esp32vn/esp32-iot-uno/README.md

# esp32-iot-uno 

## Hardware features

- ESP32 WiFi, Bluetooth LE SoC - 240Mhz - Module ESP-WROOM-32
- Automatic select 3 power sources (DC6-28V, USB and Battery)
- Auto download Flash mode
- Integrated SDCARD slot (support 1-bit mode)
- Open hardware design with KiCad, CC-BY-SA license.
- I2C OLED display header 
- Lithium-Ion Battery Charger
- 1 Reset button, 1 programable button
- 1 Power LED, 1 programable LED, 1 Charger LED 
- Compatible with Shields for ESP32 in the future (Gateway - GSM/GPRS/GPS and Lora Shield, Connectivity - CAN, RS485, RS232 Shield, Audio Shield, ...)

### Images

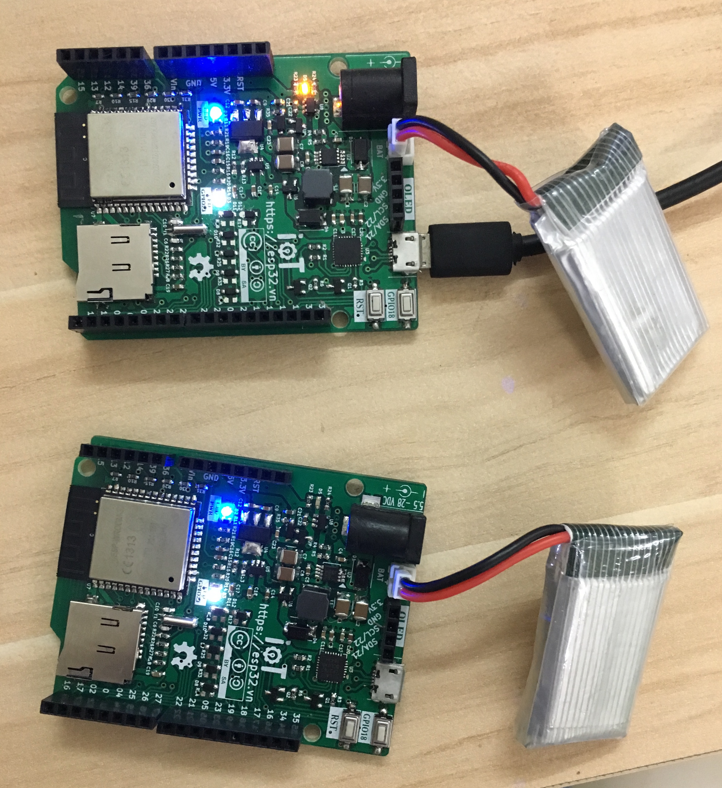
[picture p1: assets/esp32_uno_0776.jpg]
ESP32 IoT UNO Images1


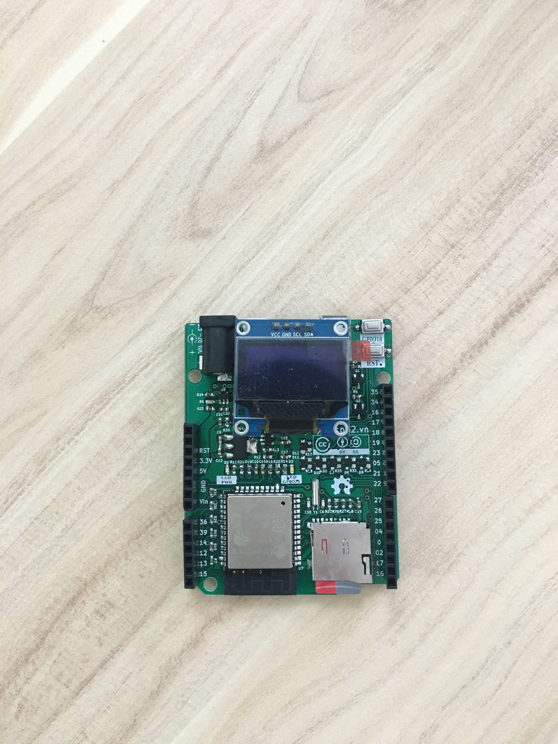
[picture p2: assets/esp32_uno_0826.jpg]
ESP32 IoT UNO Images2


### Pinout:

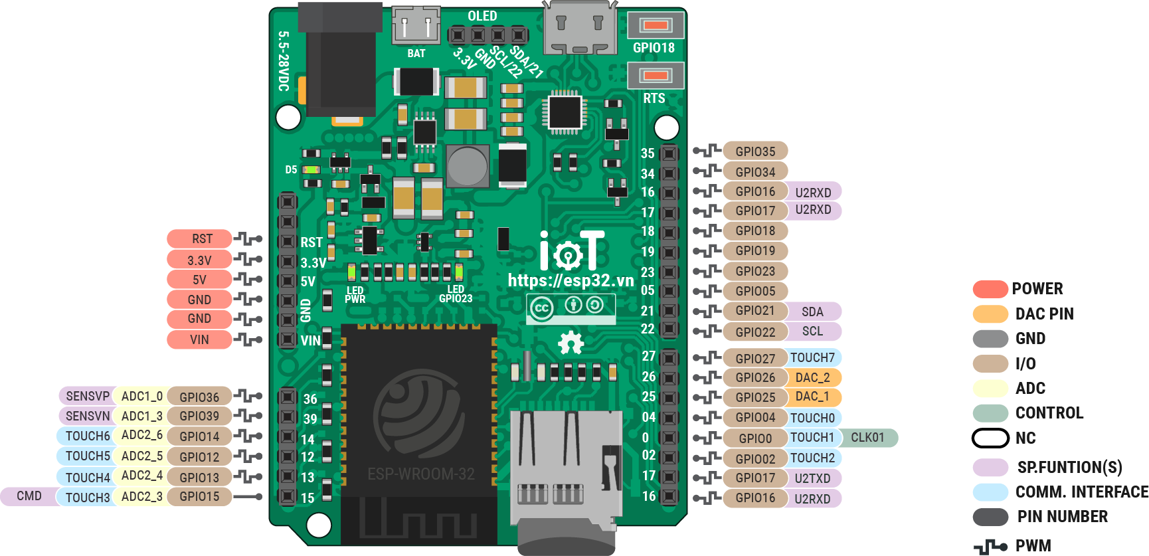
[picture p3: assets/Esp32-pinout.png]
ESP32 IoT Pinout


### Schematic

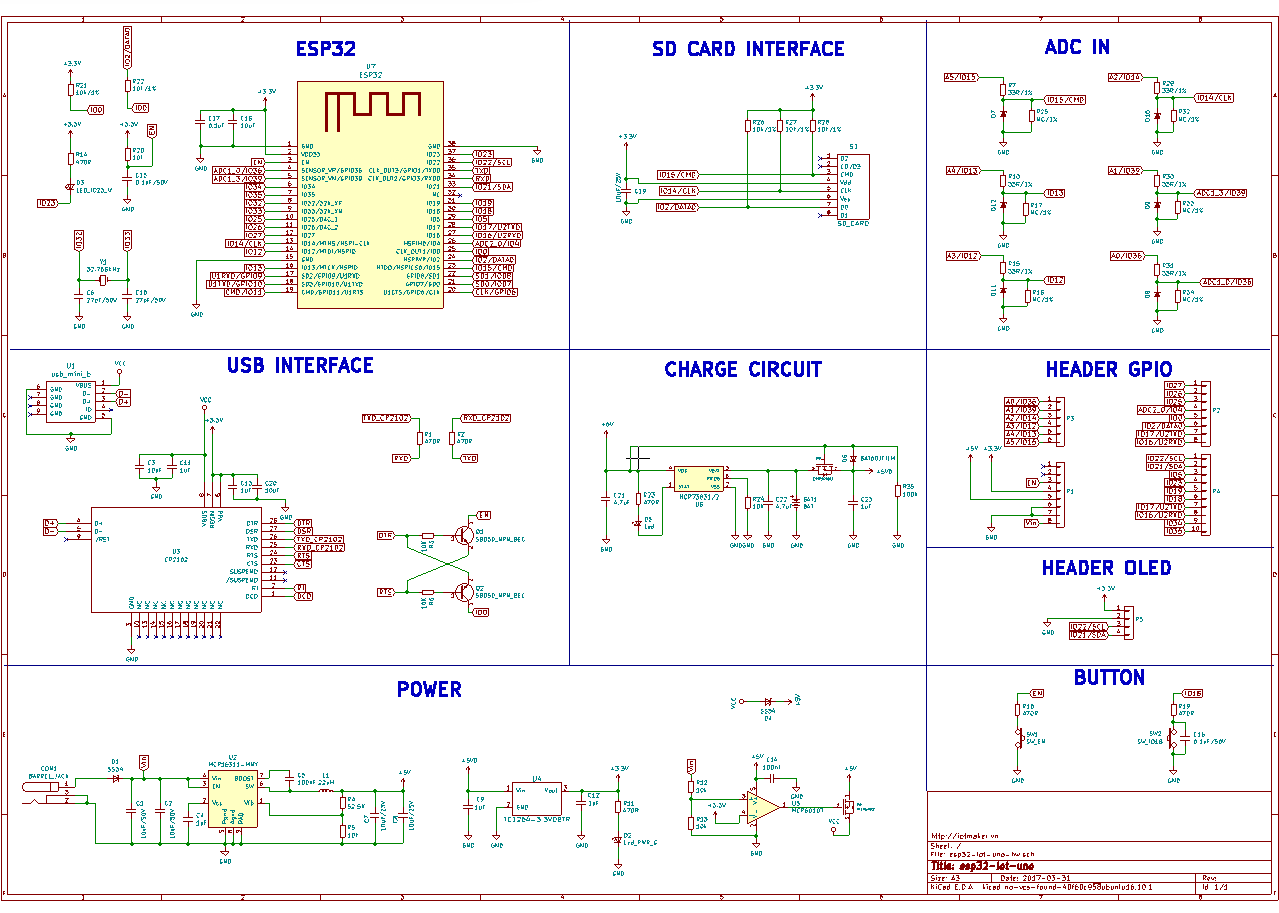
[picture p4: assets/esp32-iot-uno-sch.png]
ESP32 IoT UNO Schematic


### PCB

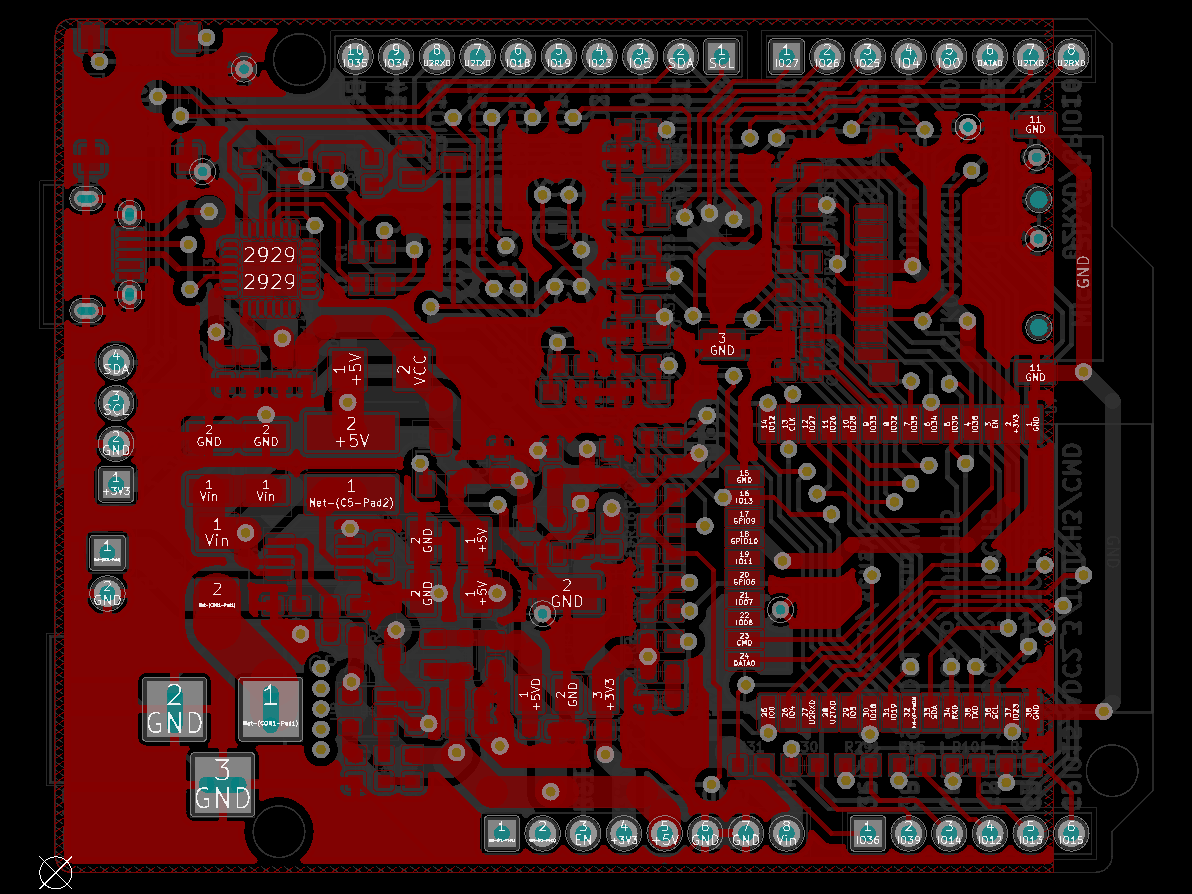
[picture p5: assets/esp32-iot-uno-pcb.png]
ESP32 IoT UNO PCB


### 3D

#### TOP

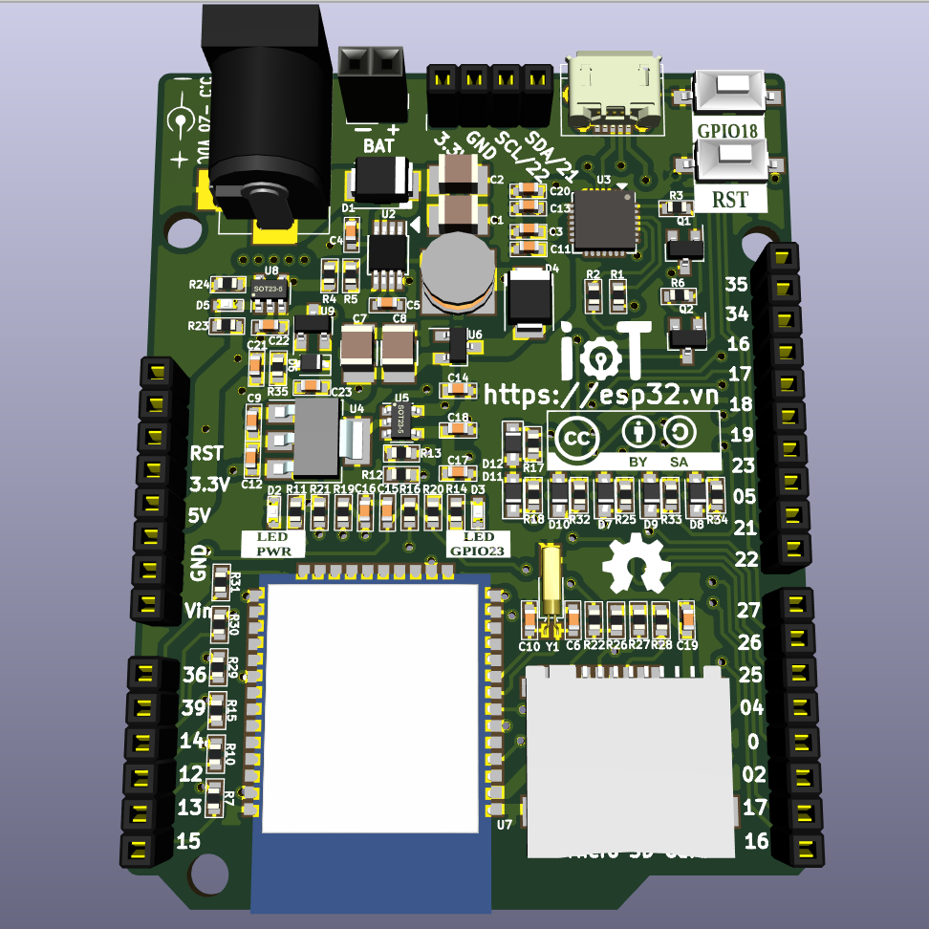
[picture p6: assets/esp32-iot-uno-3d-top.png]
ESP32 IoT UNO 3D TOP


#### DOWN

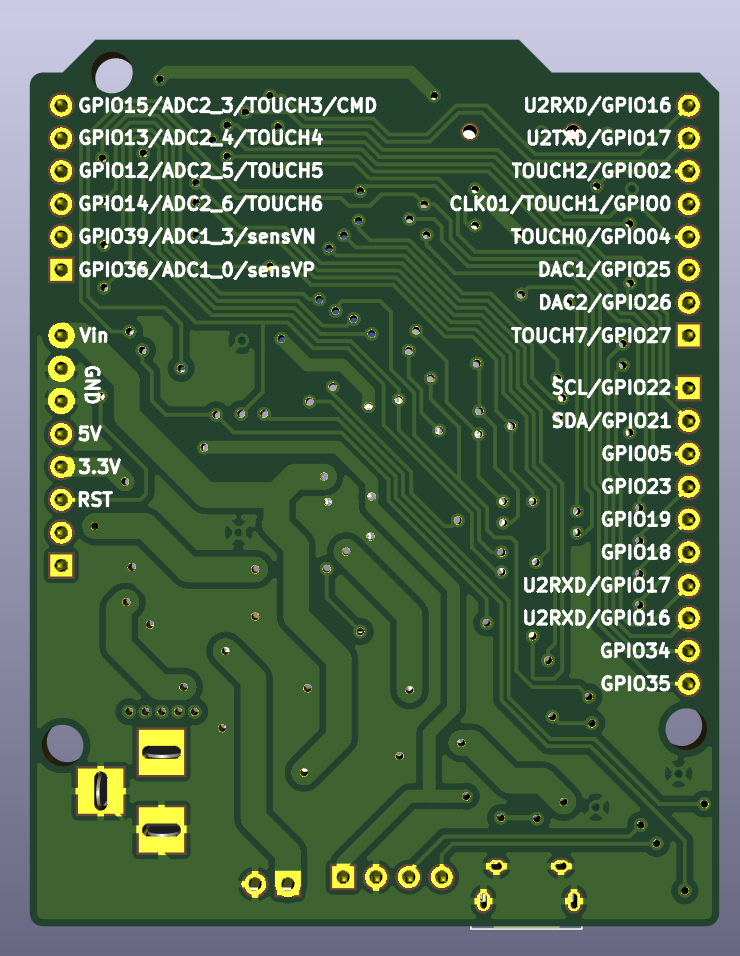
[picture p7: assets/esp32-iot-uno-3d-down.png]
ESP32 IoT UNO 3D DOWN


### Gerber

[Download](./assets/gerber.zip)

### License

- CC-BY-SA 
- This creative commons license requires you to release all derivative works under this same license. You must give credit to the original author of the work, state their name and the title of the original work, say that you modified the work if you did and include the attribution logo, website: https://esp32.vn
