esp32vn/esp32-iot-uno/(commit log)

2017-01-25 create kicad projet, schematic
    [esp32-iot-uno-hw.kicad_pcb, esp32-iot-uno-hw.sch]
2017-01-30 fix my mistake about button boot & en (Q1 & Q2)
    [esp32-iot-uno-hw.sch]
2017-01-30 add led RX, TX & SD Card interface
    [esp32-iot-uno-hw.sch]
2017-01-31 change uart0 to uart1 & update README file
    [esp32-iot-uno-hw.sch]
2017-02-01 modify header OLED & add ADC 2 from channel 0 to 5
    [esp32-iot-uno-hw.sch]
2017-02-01 completed schematic
    [esp32-iot-uno-hw.kicad_pcb, esp32-iot-uno-hw.sch]
2017-02-01 create PCB
    [esp32-iot-uno-hw.kicad_pcb, esp32-iot-uno-hw.sch]
2017-02-02 edit schematic to compatible with noduino quantum32-96%(IO16, 17 change to IO7,8 & PLUS IO6, 11 at header PWR
    [esp32-iot-uno-hw.kicad_pcb, esp32-iot-uno-hw.sch]
2017-02-03 drop *.lib in gitignore file for error not found lib
    [esp32-iot-uno-hw.kicad_pcb, esp32-iot-uno-hw.sch]
2017-02-04 Completed connect RS232
    [esp32-iot-uno-hw.kicad_pcb, esp32-iot-uno-hw.sch]
2017-02-04 Revert "Completed connect RS232"
    This reverts commit 573993575a48af5cfb442220d9b0112589d594ab.
    [esp32-iot-uno-hw.kicad_pcb, esp32-iot-uno-hw.sch]
2017-02-12 modify footprint esp32-wrover-V3
    [esp32-iot-uno-hw.kicad_pcb, esp32-iot-uno-hw.sch]
2017-02-12 add pwr 5V to header
    [esp32-iot-uno-hw.kicad_pcb, esp32-iot-uno-hw.sch]
2017-02-24 completed local component
    [esp32-iot-uno-hw.kicad_pcb, esp32-iot-uno-hw.sch]
2017-02-25 first track
    [esp32-iot-uno-hw.kicad_pcb]
2017-02-27 add swich IO02 & modify footprint ESP32 for compatible ESP32-WROVER module & ESP32S module
    [esp32-iot-uno-hw.kicad_pcb, esp32-iot-uno-hw.sch]
2017-02-27 final connected track
    [esp32-iot-uno-hw.kicad_pcb]
2017-02-28 Completed PCB
    [esp32-iot-uno-hw.kicad_pcb, esp32-iot-uno-hw.sch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]
2017-02-28 add gerber file.zip & modify README
    [esp32-iot-uno-hw-B.Mask.gbs, esp32-iot-uno-hw-B.SilkS.gbo, esp32-iot-uno-hw-F.Paste.gtp]
2017-02-28 drop header sdcard & fix PCB
    [esp32-iot-uno-hw.kicad_pcb, esp32-iot-uno-hw.sch]
2017-02-28 modify 3D component
    [esp32-iot-uno-hw.kicad_pcb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]
2017-03-02 fix track 5V,GND, header OLED & add name pinout down layer
    [esp32-iot-uno-hw.kicad_pcb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]
2017-03-02 fix track Vin & Vcc upto 1.5mm
    [esp32-iot-uno-hw.kicad_pcb]
2017-03-22 drop GPIO10,9(UART1) change to GPIO16, 17 (UART2)-repeak 2
    [esp32-iot-uno-hw.kicad_pcb, esp32-iot-uno-hw.sch]
2017-03-23 completed new PCB - with UART2: GPIO16, GPIO17 & New footprint esp-wroom-32
    [esp32-iot-uno-hw.kicad_pcb, esp32-iot-uno-hw.sch]
2017-03-24 add link download gerber in README file
2017-03-28 update gerber file
    [esp32-iot-uno-hw.kicad_pcb, esp32-iot-uno-hw.sch]
2017-03-28 resolved #2
    [esp32-iot-uno-hw.kicad_pcb]
2017-03-28 modify block ADC, drop switch io02 & connect path 2 of R22 to io0
    [esp32-iot-uno-hw.kicad_pcb, esp32-iot-uno-hw.sch]
2017-03-29 add block charge circuit schematic
    [esp32-iot-uno-hw.kicad_pcb, esp32-iot-uno-hw.sch]
2017-03-31 connect new PCB final
    [esp32-iot-uno-hw.kicad_pcb]
2017-03-31 change block PWR 3.3V to IC TC1264-3.3VDBTR
    [esp32-iot-uno-hw.kicad_pcb, esp32-iot-uno-hw.sch]
2017-03-31 Completed new PCB with block charge & PWR 3.3V TC1264
    [esp32-iot-uno-hw.kicad_pcb, esp32-iot-uno-hw.sch]
2017-03-31 modify track GND at anten ESP32
2017-04-18 fix diode charge, header charge & via at symbol GPIO23
    [esp32-iot-uno-hw.kicad_pcb, esp32-iot-uno-hw.sch]
2017-04-19 modify value pwr to 4.5 - 30VDC, 3d header charge & update gerber file
    [esp32-iot-uno-hw.kicad_pcb]
